longvotheengineer/control-motor-speed/(commit log)

2025-12-06 Update code with UART sync fix
    [PID.c, PID.h, UART.c, UART.h, isr.c]
2025-12-09 Add UART connection check command handling
2025-12-09 Add UART_RX_FAIL_CONNECTION definition
2025-12-09 Fix struct definition for UARTConnection_t
    [UART.h]
2025-12-10 refator: refactor(pins): update peripheral pin mapping for TIM3, UART, and TIM1
    - Move TIM3 encoder inputs from PA6/PA7 to PC6/PC7
    - Replace UART4 (PA0/PA1) with USART2 (PA2/PA3)
    - Move TIM1_CH1 PWM output from PA8 to PE9
    [PID.h, UART.h, isr.c, main.c, main.h]
2025-12-10 feat(usart): Implement robust RX reconnection handling
    - Clears ORE flag in ISR to prevent hardware lockup on noise/disconnect.
    - Implemented 10ms timeout using SysTick to reset buffer index for packet resync.
    - Configured internal pull-up on RX pin to minimize noise when floating.
    [UART.c, UART.h, isr.c, main.c, main.h, motor.h, protocol.h]
