longvotheengineer/control-motor-speed/(notices)

Notices in the files:
README.md:
License: MIT
